kevinrae001/Word_clock/Schematics/WC_Schematic.png

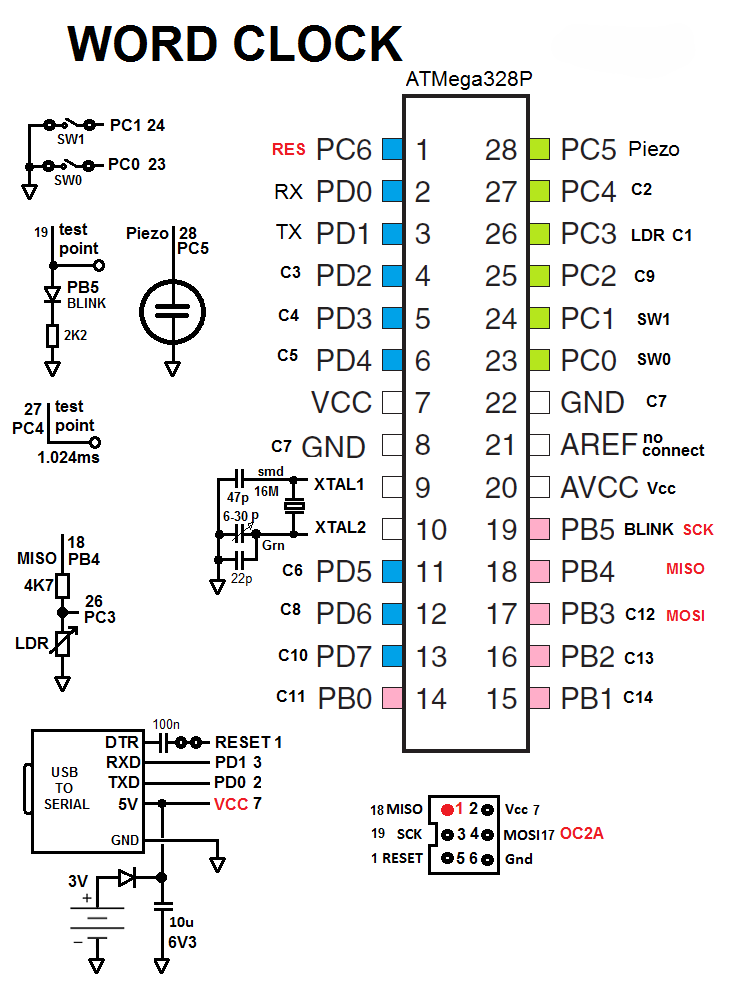
Schematics/WC_Schematic.png
