kevinrae001/Word_clock/Schematics/word_clock_hours_minutes.png

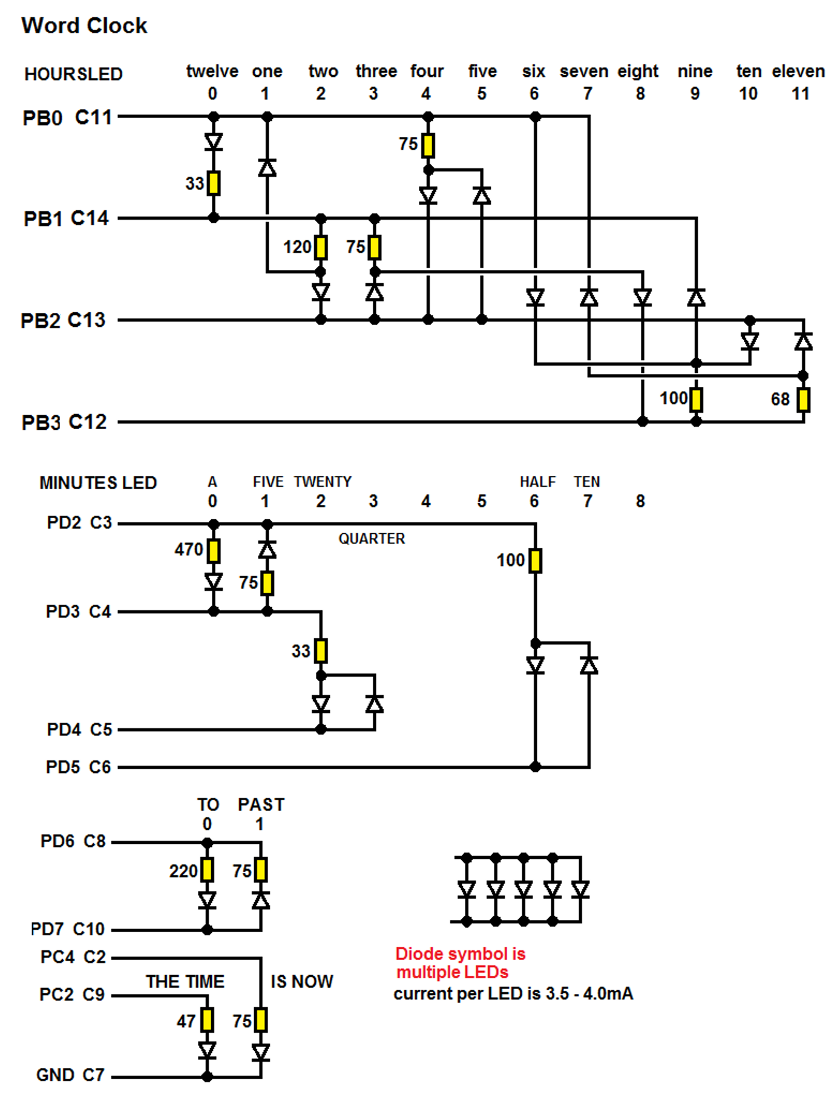
Schematics/word_clock_hours_minutes.png
