kevinrae001/Word_clock/Schematics/Word_Clock_Schematic_no_ICSP.png

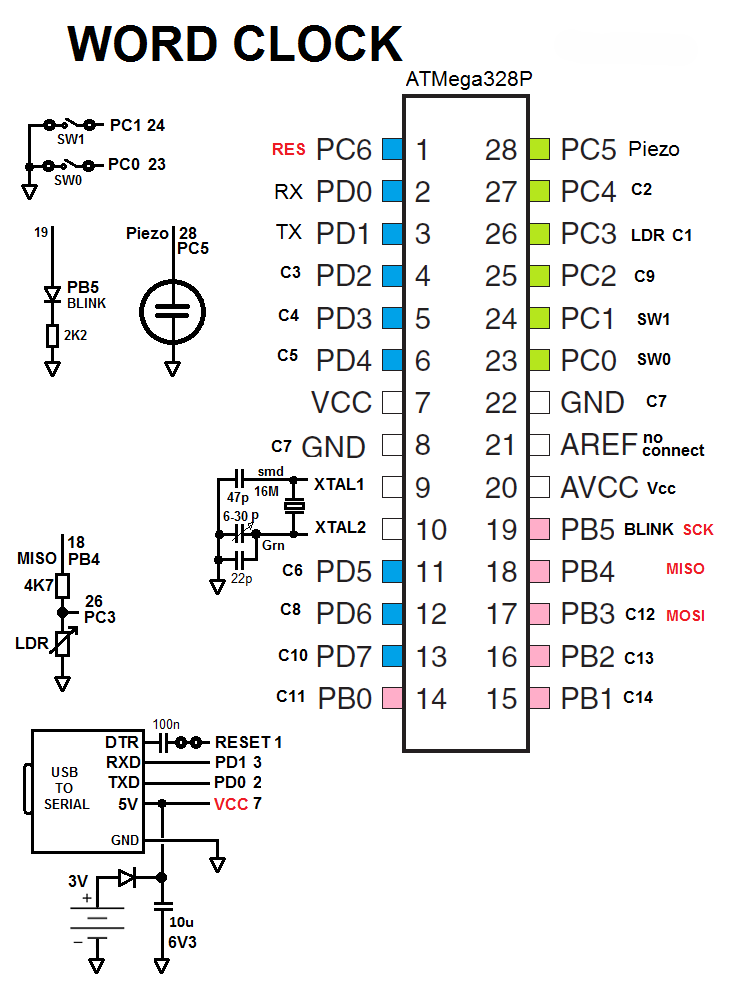
Schematics/Word_Clock_Schematic_no_ICSP.png
