kevinrae001/Word_clock/BOM.xlsx

ID | Material | Supplies | Equipment | Components | Other Direct Costs | Total(CAD)
1* | - | - | - | (1) prototype PCB 5x8cm |  | 1
2* | - | - | - | (1) Atmel ATMEGA328p microcontroller |  | 2.5
3* | - | - | - | (1) 16Mhz xtal oscillator, SMD |  | 1
4* | - | - | - | (1) USB to Serial adapter board CP2102 |  | 3
5* | - | - | - | (1) 28 PIN DIP socket |  | 0.5
6* | - | - | - | (1) Header male 14x1 0.1” right angle |  | 0.1
7* | - | - | - | (1) Header female 14x1 0.1” |  | 0.1
8* | - | - | - | (1) Header male 4x1 0.1” right angle |  | 0.1
9* | - | - | - | (1) Header male 2x1 0.1” |  | 0.1
10* | - | - | - | (1) diode general purpose signal |  | 0.1
--------------*
11* | - | - | - | (2) switch tactile 5x5x17mm |  | 1
12* | - | - | - | (1) 3V coin CR2032 battery |  | 0.5
13* | - | - | - | (1) coin CR2032 battery holder |  | 0.5
14* | - | - | - | (1) capacitor SMD 47p |  | 0.1
15* | - | - | - | (1) capacitor SMD 33p |  | 0.1
16* | - | - | - | (1) capacitor SMD 100n |  | 0.1
17* | - | - | - | (1) capacitor SMD 10u |  | 0.1
18* | - | - | - | (1) capacitor SMD 6-30p variable |  | 0.5
19* | - | - | - | (1) Piezo buzzer 30mm |  | 2
20* | - | - | - | (1) LED 3mm yellow |  | 0.1
21* | - | - | - | (1) Resistor 2k2 |  | 0.1
22* | - | - | - | (1) connecting wire, 30AWG |  | 1
23* | - | - | - | (1) resistor photo 5k |  | 0.5
24 | - | - | - | (1) IKEA frame 25x20cm |  | 6.72
 |  |  |  | foam board
 |  |  |  | inkjet clear transparency sheet
 |  |  |  | tint film
 |  |  |  | tint film spray
 |  |  |  | misc mounting hardware M3 screws
 |  |  |  | wooden craft sticks
 |  |  |  | -
25* | - | - | - | (1) foam board package |  | 4
26* | - | - | - | (1) inkjet clear transparency sheet package |  | $18.00
27* | - | - | - | (1) tint film package |  | 30
28* | - | - | - | (1) tint film spray |  | 7.26
29* | - | - | - | (1) misc mounting hardware M3 screws |  | 1
31 | - | - | - | (100) 3/5mm LED white | 3.95 | 5.22
 |  |  |  |  | (shipping)
32* | - | - | - | (1) wire 30AWG |  | 2
Total |  |  |  |  |  | 93.25
